ottehoman/SwissWordClock/Documentation/Images/doc-esp32-wrover-board-simplified-pinout.png

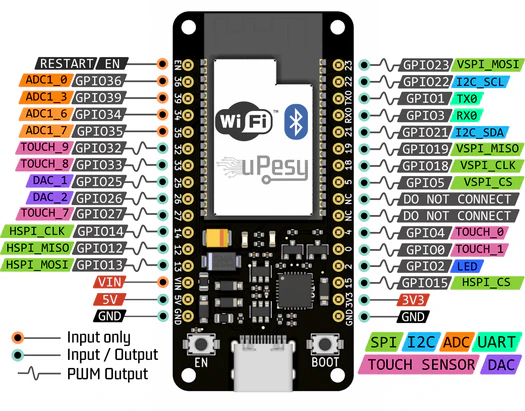
Documentation/Images/doc-esp32-wrover-board-simplified-pinout.png
