ottehoman/SwissWordClock/Documentation/Images/doc-esp32-wrover-pinout-schema.png

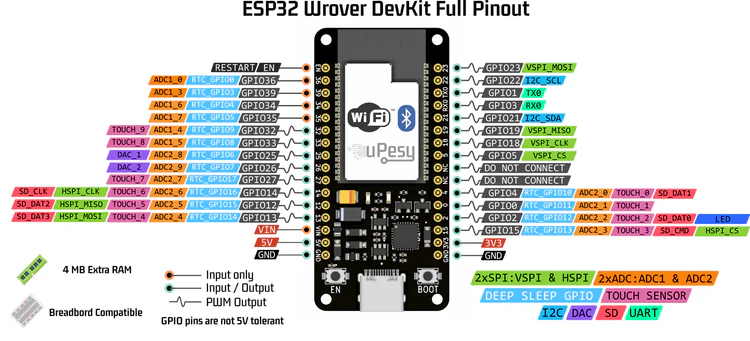
Documentation/Images/doc-esp32-wrover-pinout-schema.png
