ottehoman/SwissWordClock/Documentation/Images/baking_paper_diffuser.bmp

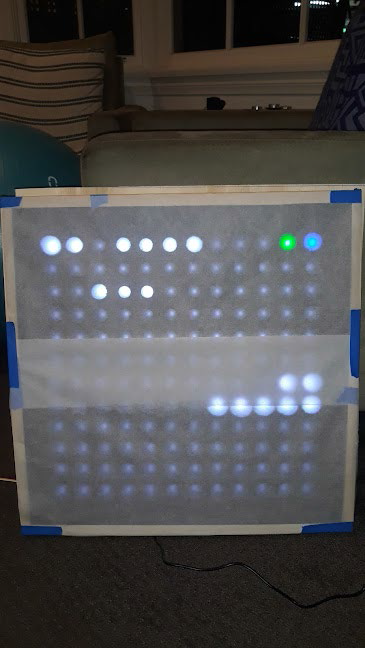
Documentation/Images/baking_paper_diffuser.bmp
