ottehoman/SwissWordClock/Documentation/Images/defer_updates.bmp

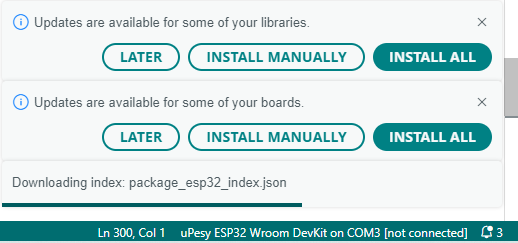
Documentation/Images/defer_updates.bmp
