ottehoman/SwissWordClock/Documentation/Images/egg.bmp

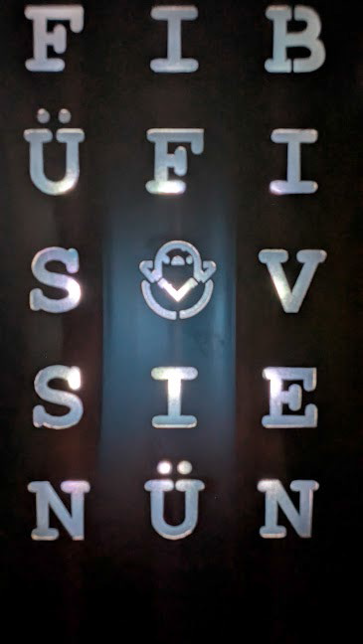
Documentation/Images/egg.bmp
