ottehoman/SwissWordClock/Documentation/Images/esp32_library.bmp

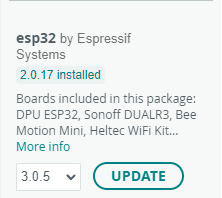
Documentation/Images/esp32_library.bmp
