ottehoman/SwissWordClock/Documentation/Images/LED_mask.bmp

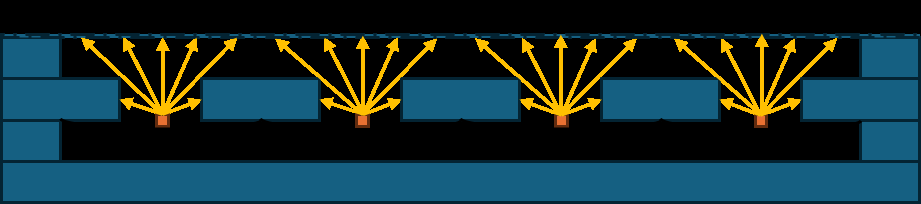
Documentation/Images/LED_mask.bmp
