ottehoman/SwissWordClock/Documentation/Images/neopixel_library.bmp

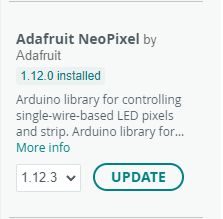
Documentation/Images/neopixel_library.bmp
