ottehoman/SwissWordClock/Documentation/Images/on_the_wall_day.bmp

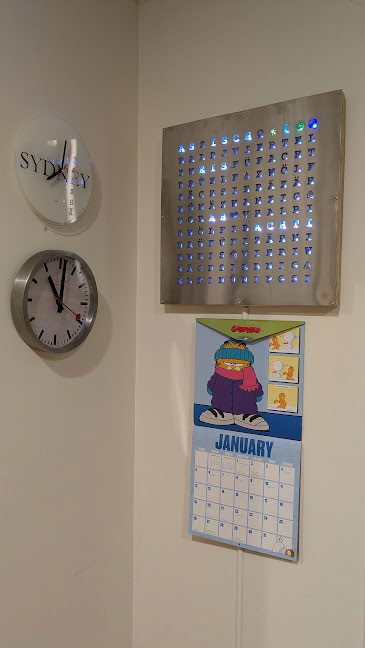
Documentation/Images/on_the_wall_day.bmp
