ottehoman/SwissWordClock/Documentation/Images/on_the_wall_night.bmp

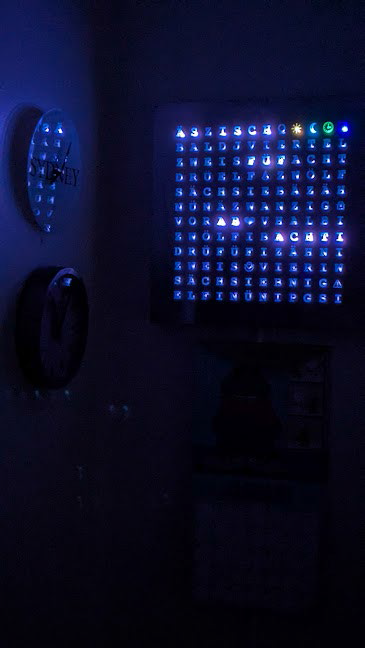
Documentation/Images/on_the_wall_night.bmp
