ottehoman/SwissWordClock/Documentation/Images/on_the_wall_night_front_view.bmp

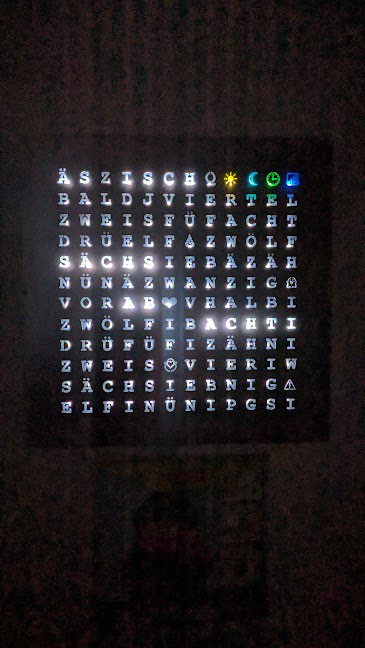
Documentation/Images/on_the_wall_night_front_view.bmp
