ottehoman/SwissWordClock/(commit log)

2024-10-30 Added HOSTNAME for WiFi
    Added HOSTNAME for WiFi connections. Otherwise device shows up as "esp32-0532d8.lan"
2024-10-30 Fixed Halloween Ghost
    Fixed Halloween Ghost - _showHalloween() was missing in the _showDisplay() call def
    [WordClock.cpp, WordClock.h]
